wereallgeek/CX16cart/images/3d-blue-bottom.png

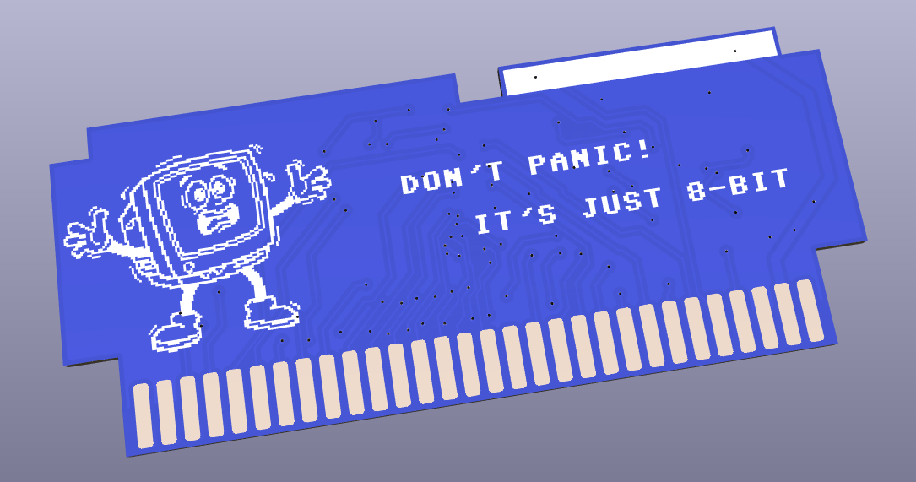
images/3d-blue-bottom.png
