wereallgeek/CX16cart/images/3d-bottom.png

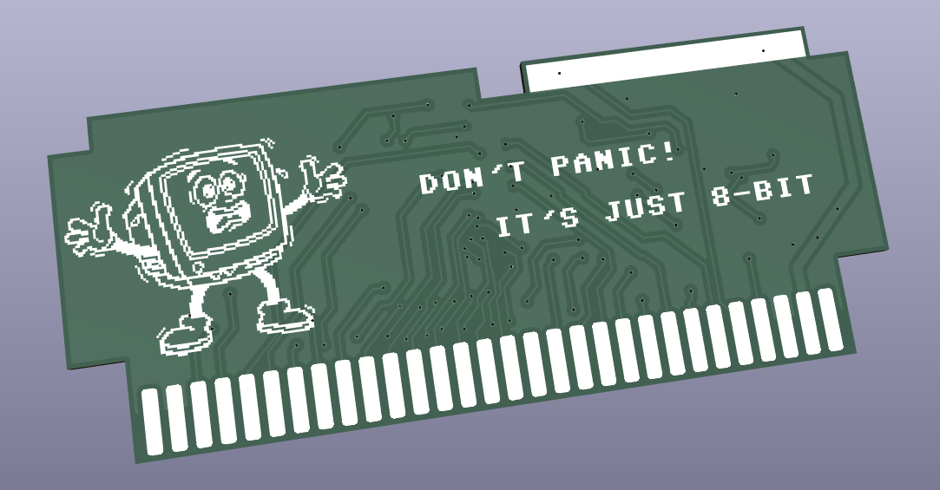
images/3d-bottom.png
