wereallgeek/CX16cart/images/3d-front.png

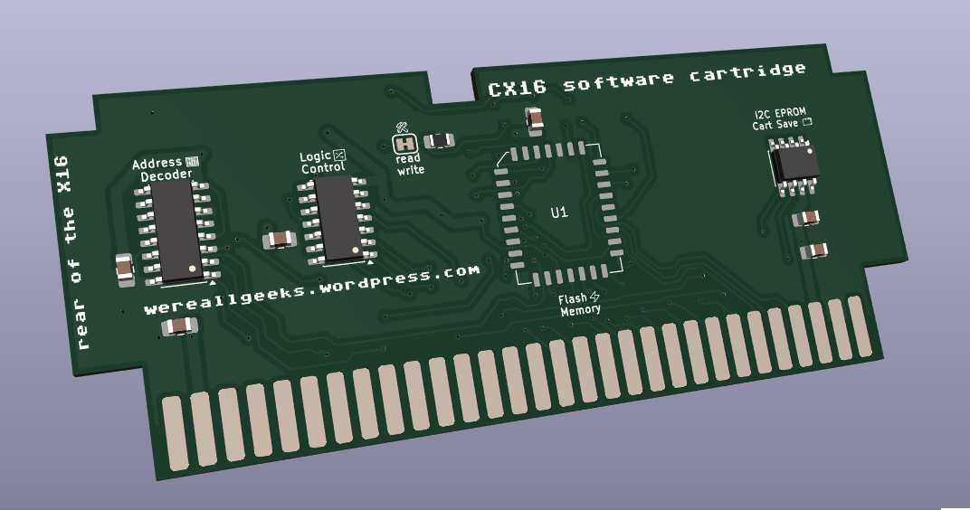
images/3d-front.png
