wereallgeek/CX16cart/images/bottom.png

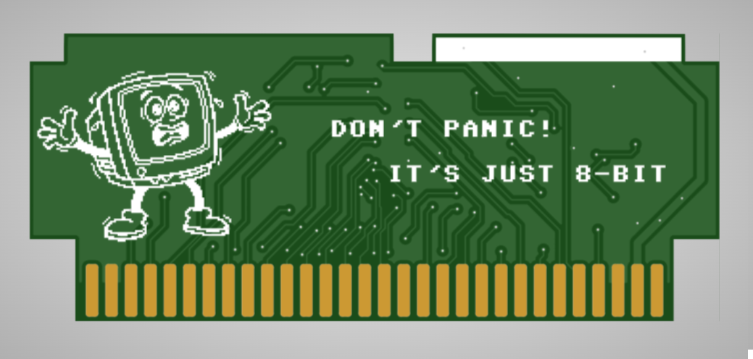
images/bottom.png
