wereallgeek/CX16cart/images/front.png

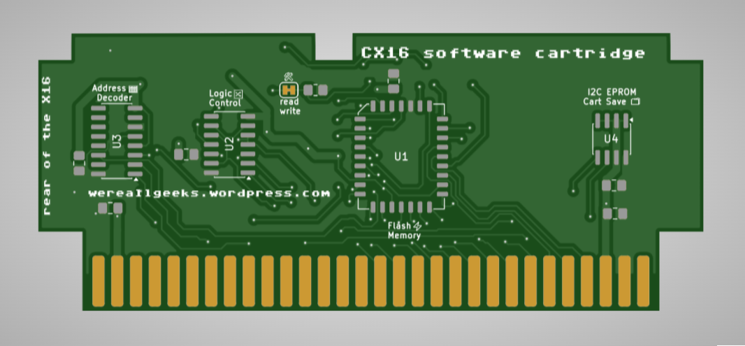
images/front.png
