wereallgeek/CX16cart/images/PCBdesign.png

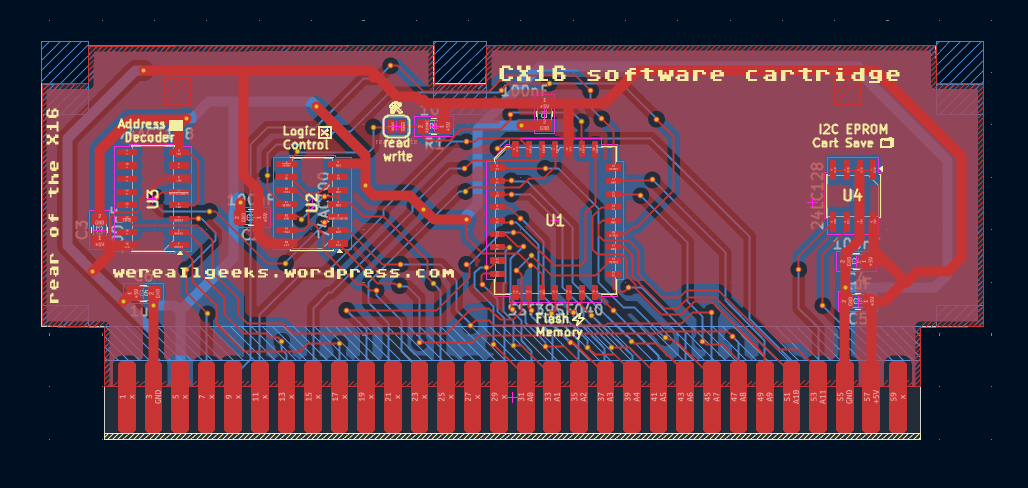
images/PCBdesign.png
