wereallgeek/CX16cart/PCB/CX16-cart/CX16-cart.kicad_pcb

## KiCad design PCB/CX16-cart/CX16-cart.kicad_pcb (2026-10-30)

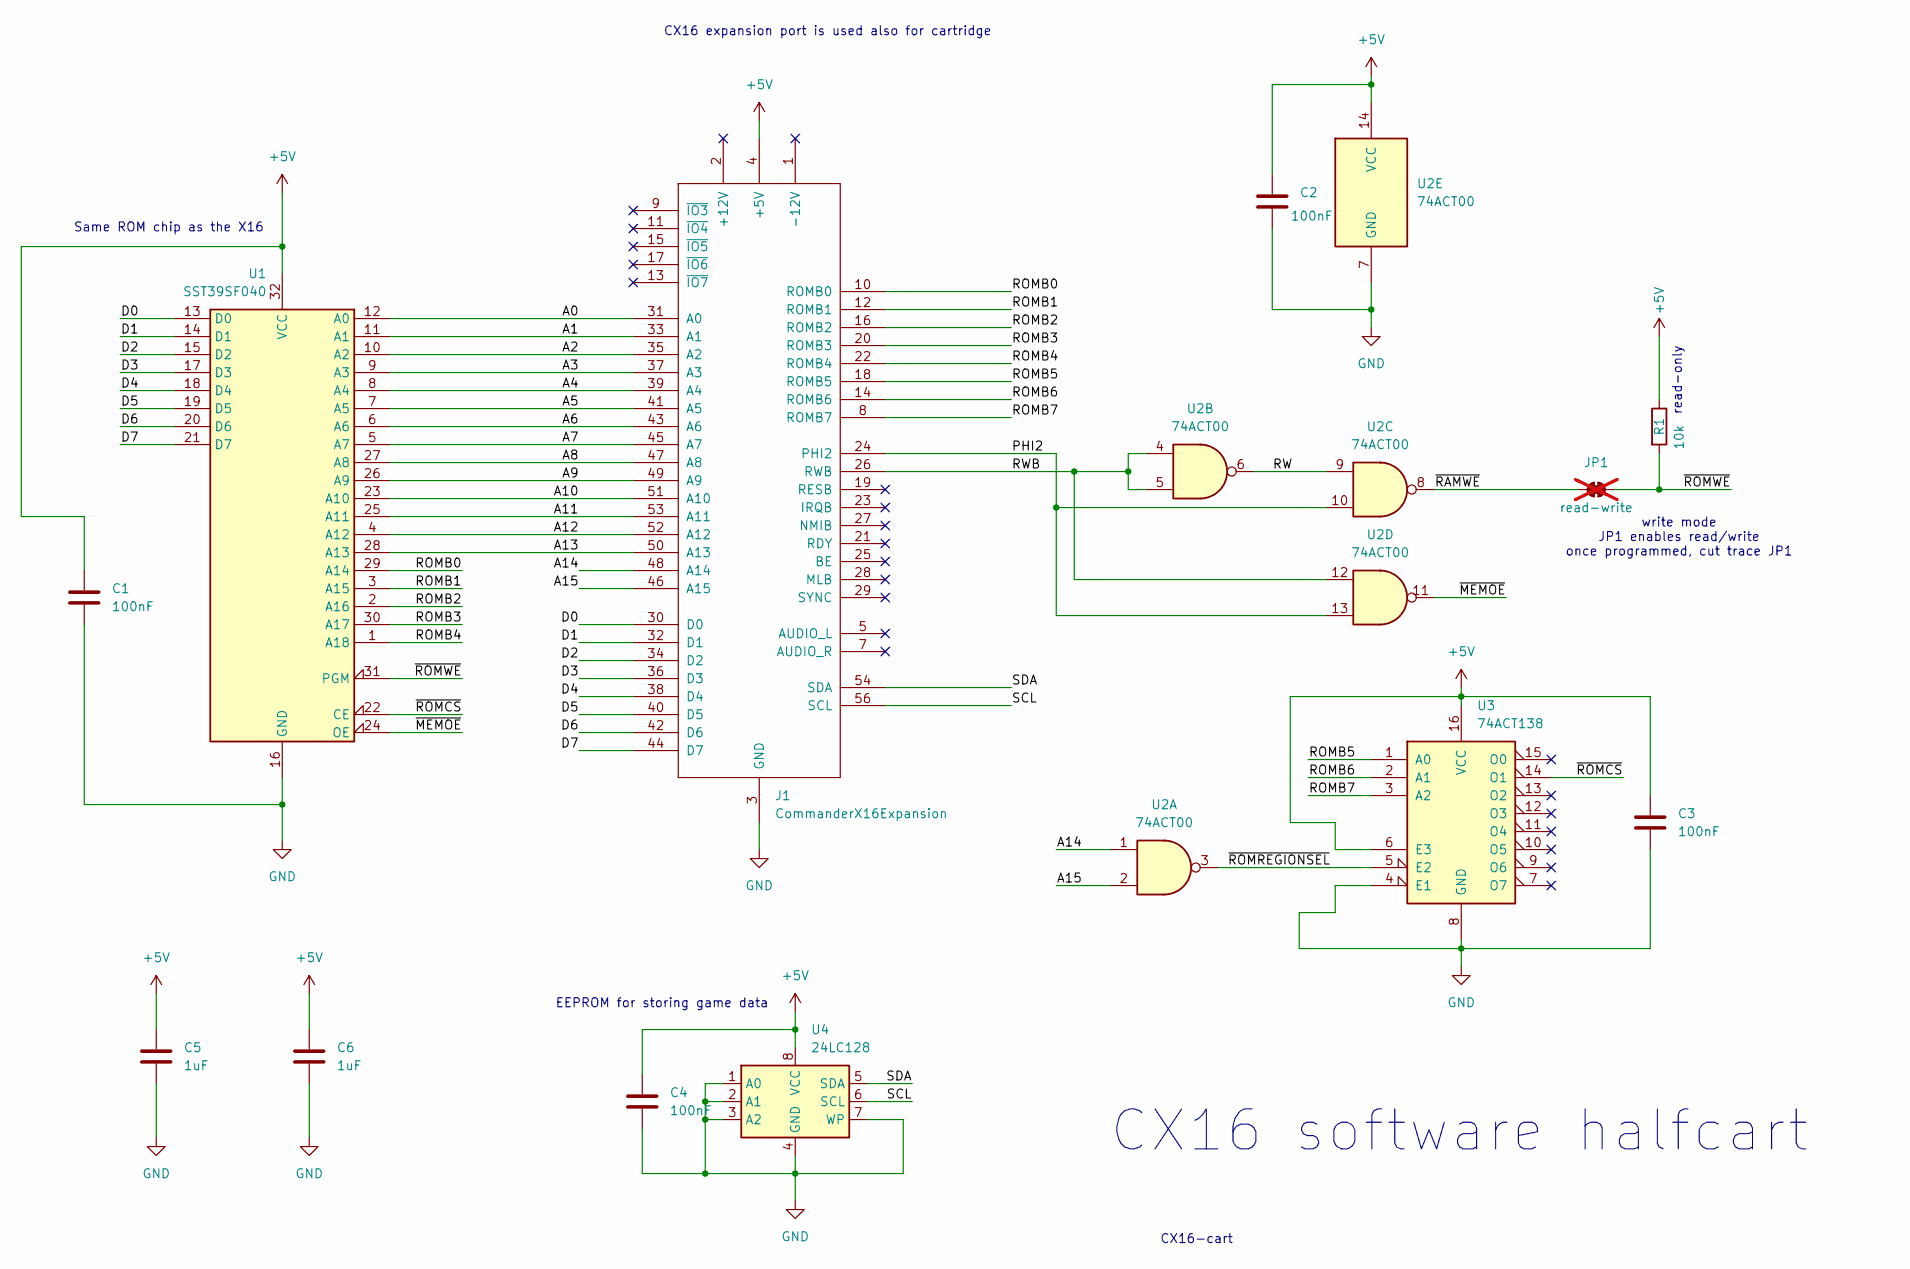
[picture p8: schematic CX16-cart.kicad_sch]

Parts:
C1, C2, C3, C4: 100nF; C_0805_2012Metric_Pad1.18x1.45mm_HandSolder; MPN CL21B104KBCNNNC
C5, C6: 1uF; C_0805_2012Metric_Pad1.18x1.45mm_HandSolder; MPN CL21B105KBFNNNE
J1: CommanderX16Expansion; CX16HalfCart
JP1: read-write; Jumper_2_NC_Trace; not fitted
R1: 10k; R_0805_2012Metric_Pad1.20x1.40mm_HandSolder; MPN RC0805FR-0710KL
U1: SST39SF040; PLCC-32_11.4x14.0mm_P1.27mm; MPN SST39SF040-70-4C-NHE
U2: 74ACT00; SOIC-14_3.9x8.7mm_P1.27mm; MPN SN74ACT00D
U3: 74ACT138; SOIC-16_3.9x9.9mm_P1.27mm; MPN CD74ACT138M96
U4: 24LC128; SOIC-8_3.9x4.9mm_P1.27mm; MPN 24LC128-I/SN

Connections:
+5V: C1.1, C2.1, C3.1, C4.1, C5.1, C6.1, J1.4 (+5V), J1.57 (+5V), R1.1, U1.32 (VCC), U2.14 (VCC), U3.6 (E3), U3.16 (VCC), U4.8 (VCC)
/A0: J1.31 (A0), U1.12 (A0)
/A1: J1.33 (A1), U1.11 (A1)
/A2: J1.35 (A2), U1.10 (A2)
/A3: J1.37 (A3), U1.9 (A3)
/A4: J1.39 (A4), U1.8 (A4)
/A5: J1.41 (A5), U1.7 (A5)
/A6: J1.43 (A6), U1.6 (A6)
/A7: J1.45 (A7), U1.5 (A7)
/A8: J1.47 (A8), U1.27 (A8)
/A9: J1.49 (A9), U1.26 (A9)
/A10: J1.51 (A10), U1.23 (A10)
/A11: J1.53 (A11), U1.25 (A11)
/A12: J1.52 (A12), U1.4 (A12)
/A13: J1.50 (A13), U1.28 (A13)
/A14: J1.48 (A14), U2.1
/A15: J1.46 (A15), U2.2
/D0: J1.30 (D0), U1.13 (D0)
/D1: J1.32 (D1), U1.14 (D1)
/D2: J1.34 (D2), U1.15 (D2)
/D3: J1.36 (D3), U1.17 (D3)
/D4: J1.38 (D4), U1.18 (D4)
/D5: J1.40 (D5), U1.19 (D5)
/D6: J1.42 (D6), U1.20 (D6)
/D7: J1.44 (D7), U1.21 (D7)
/PHI2: J1.24 (PHI2), U2.10, U2.13
/ROMB0: J1.10 (ROMB0), U1.29 (A14)
/ROMB1: J1.12 (ROMB1), U1.3 (A15)
/ROMB2: J1.16 (ROMB2), U1.2 (A16)
/ROMB3: J1.20 (ROMB3), U1.30 (A17)
/ROMB4: J1.22 (ROMB4), U1.1 (A18)
/ROMB5: J1.18 (ROMB5), U3.1 (A0)
/ROMB6: J1.14 (ROMB6), U3.2 (A1)
/ROMB7: J1.8 (ROMB7), U3.3 (A2)
/RW: U2.6, U2.9
/RWB: J1.26 (RWB), U2.4, U2.5, U2.12
/SCL: J1.56 (SCL), U4.6 (SCL)
/SDA: J1.54 (SDA), U4.5 (SDA)
/~MEMOE: U1.24 (OE), U2.11
/~RAMWE: JP1.1 (A), U2.8
/~ROMCS: U1.22 (CE), U3.14 (O1)
/~ROMREGIONSEL: U2.3, U3.5 (E2)
/~ROMWE: JP1.2 (B), R1.2, U1.31 (PGM)
GND: C1.2, C2.2, C3.2, C4.2, C5.2, C6.2, J1.3 (GND), J1.6 (GND), J1.55 (GND), J1.58 (GND), U1.16 (GND), U2.7 (GND), U3.4 (E1), U3.8 (GND), U4.1 (A0), U4.2 (A1), U4.3 (A2), U4.4 (GND), U4.7 (WP)

Notes on the sheet:
CX16 expansion port is used also for cartridge
write mode JP1 enables read/write once programmed, cut trace JP1
read-only
EEPROM for storing game data
CX16-cart
CX16 software halfcart
Same ROM chip as the X16

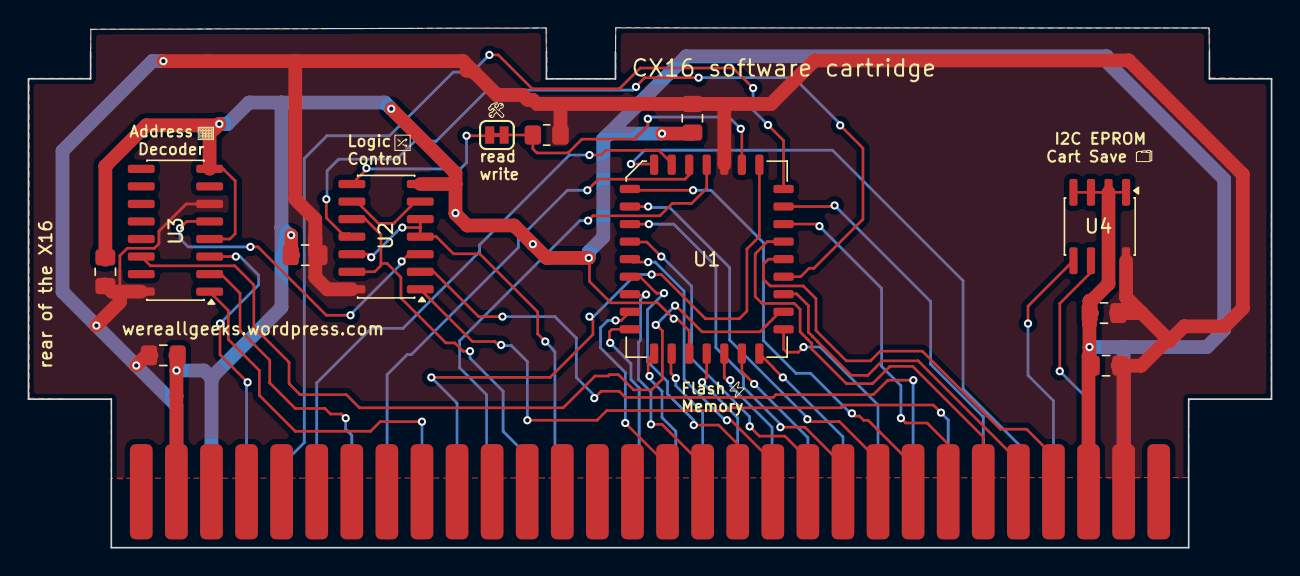
[picture p9: board CX16-cart.kicad_pcb from above]

Board: 2 copper layers, 90.0 x 37.6 mm, 14 parts (1 on the bottom side), 44 nets.

Other parts of the board:
PixelPanic: LOGO
