wereallgeek/CX16cart/(commit log)

2026-10-25 initial cart PCB project
    (empty)
    [CX16-cart.kicad_pcb, CX16-cart.kicad_sch]
2026-10-25 initial PCB shape (half cart)
    Added https://github.com/jkominek/x16expansion
    Altered footprint for half-cart.
    This is the most basic setup, nothing populated yet.
    [CX16-cart.kicad_pcb, CX16-cart.kicad_sch]
2026-10-26 first pass
    first complete schematic with successful routing.
    using THT ROM chip (socket)
    [CX16-cart.kicad_pcb, CX16-cart.kicad_sch]
2026-10-26 working on artwork
    [CX16-cart.kicad_pcb]
2026-10-26 artwork inversion
    [CX16-cart.kicad_pcb]
2026-10-26 ROM chip markings
    [CX16-cart.kicad_pcb]
2026-10-27 changed some stuff around
    All surface mount, different IC order.
    [CX16-cart.kicad_pcb, CX16-cart.kicad_sch]
2026-10-27 ground and power pane
    [CX16-cart.kicad_pcb]
2026-10-27 fixing it up
    [CX16-cart.kicad_pcb]
2026-10-27 better filterinng caps placement, better pane
    [CX16-cart.kicad_pcb]
2026-10-27 moar panning
    [CX16-cart.kicad_pcb]
2026-10-28 betterware
    Added filtering caps for entering 5V
    changed JP2 for a resistor footprint - may want to resistor it instead of short
    added chip description silkscreen
    silkscreened logos for all frontface desc text
    [CX16-cart.kicad_pcb, CX16-cart.kicad_sch]
2026-10-28 changed read/write to a single jumper
    rework silkscreen
    changed jumper for read mode
    begin to document component for the BOM
    [CX16-cart.kicad_pcb, CX16-cart.kicad_sch]
2026-10-28 3-pin jumper
    rework read mode jumper
    rework gnd/power pane zones
    rework vias
    some work on parts numbers
    [CX16-cart.kicad_pcb, CX16-cart.kicad_sch]
2026-10-28 back to jumper pads
    lots of maintenance on to get board ready.
    Tried to properly populate all parts numbers. MPN = Manufacturer's part number.
    back to jumper pads. the headers and shunt was big (high) and non-practical for ordering. It is always possible to cut the jumper. The readonly is "automagically" selected (as it is now a resistor)
    In case of problem perhaps simply short it. Issue with possible short is that both cannot be shorted at the same time, it would feed direct 5V where it is not appreciated.
    [CX16-cart.csv, CX16-cart.kicad_pcb, CX16-cart.kicad_sch]
2026-10-28 ignoring BOM file in GIT
    [CX16-cart.csv]
2026-10-30 74138 part number update
    matching PCBWay's available MPN
    [CX16-cart.kicad_pcb, CX16-cart.kicad_sch]
